SetZero/ARMband/armband.kicad_pcb

## KiCad design armband.kicad_pcb (2024-02-23)

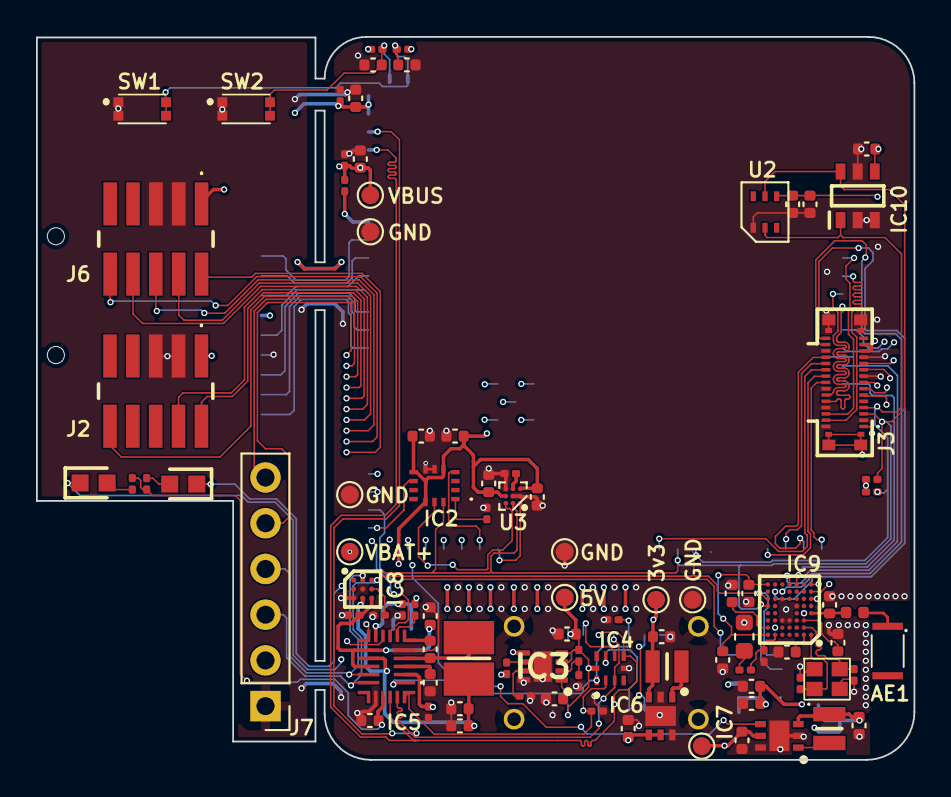
[picture p1: board armband.kicad_pcb from above]

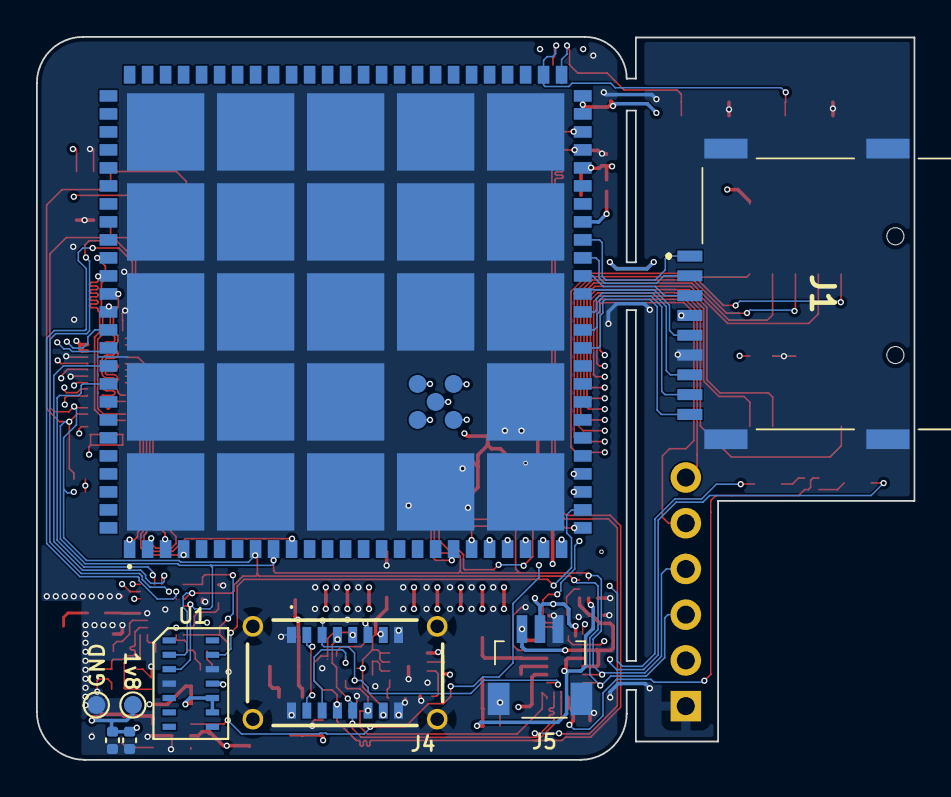
[picture p2: board armband.kicad_pcb from below]

Board: 6 copper layers, 48.8 x 40.2 mm, 101 parts (9 on the bottom side), 90 nets.

Parts:
AE1: Antenna_Chip; ST0147-00-011-A
C1, C2, C4, C6, C7, C8, C9, C25, C26, C29, C30, C31, C33, C40, C41: 100n 16V; C_0402_1005Metric
C3, C5, C11, C22, C32: 1u 6.3V; C_0201_0603Metric
C10: 3n3 50V; C_0402_1005Metric
C12: 22n 25V; C_0402_1005Metric
C13, C14, C15, C16, C17, C19, C20, C21, C27, C28: 10u 6.3V; C_0402_1005Metric
C18, C24, C34: 4u7 6.3V; C_0402_1005Metric
C23, C42: 2u2 6.3V; C_0201_0603Metric
C35, C36: 100p; C_0402_1005Metric
C37, C38: 12p 50V; C_0201_0603Metric
C39: 0p8 16V; C_0402_1005Metric
D1, D2: LED_Small; LEDC1608X80N
IC1: QSMP-1570; QSMP1570_better
IC2: BMI323
IC3: TPS259571DSGR; SON50P200X200X80-9N
IC4: TPD6E001RSERG4
IC5: MP2722GRH-0000-Z; MP2722GRH0000Z
IC6: TPS62291DRVR; SON65P200X200X80-7N
IC7: TPS62293DRVR; SON65P200X200X80-7N
IC8: BQ27427YZFR; BGA9C50P3X3_158X162X62
IC9: nRF52832-CIAA-G-R7; BGA50C40P7X8_296X323X40
IC10: TLE493DW2B6A0HTSA1; SOT95P280X110-6N
J1: MEM2075-00-140-01-A; MEM20750014001A
J2, J6: Conn_02x05_Odd_Even; 2002112100010T4LF
J3: AXF5D3012; display_AXF5D3012
J4: UJ20-C-V-SMT-TR-68; UJ20CVSMTTR68
J5: SM03B-SRSS-TB_LF__SN_; SM03BSRSSTBLFSN
J7: Conn_01x06; PinHeader_1x06_P2.54mm_Vertical
L1: 2u2; INDC3225X120N
L2, L3: 2u2; LQM2MPN1R0NG0L
L4: 10u; L_0603_1608Metric
L5: 15n; L_0201_0603Metric
L6: 3n9; L_0402_1005Metric
R1, R2, R3, R4, R6, R13: 10k; R_0201_0603Metric
R5: 0R; R_0201_0603Metric
R7: 1M; R_0201_0603Metric
R8: 100k; R_0201_0603Metric
R9: 383k; R_0201_0603Metric
R10: 1k; R_0201_0603Metric
R11, R12: 5k1 50mW; R_0201_0603Metric
R14: R_Small; R_0201_0603Metric
R15, R16: 92R; R_0201_0603Metric
SW1, SW2: EVP-BB2A9B000; EVPBB2A9B000
TP1, TP2, TP3, TP4, TP5, TP6, TP7, TP8, TP9, TP10, TP11: TestPoint; TestPoint_Pad_D1.0mm
U1: MAX30102
U2: VEML3235
U3: BMM350; bmm350
Y2: Crystal_GND24; CX2016SA

Connections:
+1V8: C7.1, C8.1, C20.1, C24.1, C25.1, C40.1, C41.1, IC2.5 (VDDIO), IC2.8 (VDD), IC2.12 (CSB), IC7.3 (FB), J3.13 (VIO18), J3.14 (VIO18), L3.1, TP5.1, U1.11 (VDD), U3.B3 (VDDIO), U3.C1 (VDD)
+3V3: C3.1, C4.1, C16.1, C26.1, C27.1, C28.1, C29.1, C30.1, IC1.49 (VIN_1), IC1.50 (VIN_2), IC6.3 (FB), IC10.4 (VDD), J1.P4 (VDD), J2.1, J3.8 (TP_VDD), J3.31 (VPH_PWR), J6.1, J7.2, L2.1, R1.1, R2.1, R3.1, R4.1, R8.1, TP4.1, U1.9 (VLED+), U1.10 (VLED+), U2.4 (VDD)
/supply/VIN_FAULT: IC3.6 (~FLT), R8.2
BMI_INT1: IC1.20 (ENET_CK125), IC2.4 (INT1)
BMI_INT2: IC1.26 (ENET_RXD0), IC2.9 (INT2)
BMM350_INT: IC1.19 (ENET_RST), U3.A1 (INT)
BT_ANT: C39.1, IC9.D1 (ANT), L6.2
DEC2: C35.1, IC9.A2 (DEC2)
DEC3: C36.1, IC9.C2 (DEC3)
DEC4: C32.1, IC9.A6 (DEC4), L5.1
GND: C1.2, C2.2, C3.2, C4.2, C5.2, C6.2, C7.2, C8.2, C9.2, C10.2, C11.2, C13.2, C14.2, C15.2, C16.2, C17.2, C18.2, C19.2, C20.2, C21.2, C22.2, C23.2, C24.2, C25.2, C26.2, C27.2, C28.2, C29.2, C30.2, C31.2, C32.2, C33.2, C34.1, C35.2, C36.2, C37.2, C38.2, C39.2, C40.2, C41.2, C42.2, IC1.101 (EP_1), IC2.6 (GNDIO), IC2.7 (GND), IC3.8 (GND_1), IC3.9 (GND_2), IC4.5 (GND), IC5.5 (PGND), IC5.18 (AGND), IC6.2 (MODE), IC6.6 (GND), IC6.7 (EP), IC7.2 (MODE), IC7.6 (GND), IC7.7 (EP), IC8.B2 (VSS_1), IC8.C1 (VSS_2), IC9.C4 (VSS_1), IC9.C5 (VSS_2), IC9.D2 (VSS_PA), IC9.E3 (VSS_3), IC9.F5 (VSS_4), IC10.2 (GND), IC10.3 (GND_2), IC10.5 (GND_3), J1.MP1, J1.MP2, J1.MP3, J1.MP4 (MP), J1.P6 (VSS), J2.3, J2.5, J3.2 (GND), J3.9 (GND), J3.12 (GND), J3.18 (GND), J3.24 (GND), J3.27 (GND), J3.30 (GND), J4.A1 (GND_1), J4.A12 (GND_2), J4.B1 (GND_3), J4.B12 (GND_4), J4.MH1, J4.MH2, J4.MH3, J4.MH4, J5.3 (GND), J5.MP1 (MP), J5.MP2 (MP), J6.3, J6.5, J7.1, R6.2, R9.2, R10.2, R11.2, R12.2, R14.2, SW1.1 (A), SW2.1 (A), TP7.1, TP8.1, TP9.1, TP10.1, TP11.1, U1.4 (PGND), U1.12 (GND), U2.1 (GND), U3.B1 (GND), U3.B2 (ADSEL), U3.C3 (BYPASS), Y2.2, Y2.4
JTAG_NRST: IC1.A1 (JTAG_TRST_B), J6.10
JTAG_TCK: IC1.C3 (JTAG_TCK), J6.4
JTAG_TDI: IC1.C1 (JTAG_TDI), J6.8
JTAG_TDO: IC1.B2 (JTAG_TDO), J6.6
JTAG_TMS: IC1.A3 (JTAG_TMS), J6.2
LCD_RST: IC1.22 (ENET_MDIO), J3.10 (LCD_RST)
LCD_TE: IC1.21 (ENET_INT), J3.11 (LCD_TE)
MAX_INT: IC1.27 (ENET_RXD1), U1.13 (~INT)
MP2722_INT: IC1.28 (ENET_RXD2), IC5.8 (~INT)
NFC_ANT1: IC9.G6 (NFC1/P0.09), J3.16 (NFC_ANT2)
NFC_ANT2: IC9.G5 (NFC2_/P0.10), J3.17 (NFC_ANT1)
NRF_NRST: IC9.H1 (P0.21_/NRESET), J2.10
NRF_SWCLK: IC9.F1 (SWDCLK), J2.4
NRF_SWDIO: IC9.G1 (SWDIO), J2.2
unnamed: AE1.1 (FEED), L6.1
unnamed: D1.2 (A), R15.1
unnamed: D1.1 (K), IC5.9 (PG/_NTC2)
unnamed: D2.2 (A), R16.1
unnamed: D2.1 (K), IC5.11 (STAT/_IB)
unnamed: IC1.43 (USBA_VBUS), R5.2
unnamed: IC2.1 (SDO), R6.1
unnamed: C10.1, IC3.1 (DVDT)
unnamed: IC3.2 (EN/UVLO), R7.2, R9.1
unnamed: IC3.7 (ILM), R10.1
unnamed: C9.1, IC3.3 (IN_1), IC3.4 (IN_2), IC4.10 (VCC), J4.A4 (VBUS_1), J4.A9 (VBUS_2), J4.B4 (VBUS_3), J4.B9 (VBUS_4), R7.1, TP2.1
unnamed: IC4.1 (IO1), IC5.1 (CC1), J4.A5 (CC1), R11.1
unnamed: IC4.2 (IO2), IC5.22 (CC2), J4.B5 (CC2), R12.1
unnamed: IC4.7 (IO5), J4.A8 (SBU1)
unnamed: IC4.8 (IO6), J4.B8 (SBU2)
unnamed: C12.2, IC5.6 (BST)
unnamed: C21.1, IC5.3 (PMID)
unnamed: C12.1, IC5.4 (SW), L1.1
unnamed: C18.1, IC5.19 (VCC), R15.2, R16.2
unnamed: IC5.7 (VRNTC), R13.1
unnamed: IC6.1 (SW), L2.2
unnamed: IC7.1 (SW), L3.2
unnamed: C23.1, IC8.B3 (VDD)
unnamed: IC9.B6 (DCC), L4.2
unnamed: C31.1, IC9.B7 (DEC1)
unnamed: C33.1, C34.2, IC9.A7 (VDD_1), IC9.H7 (VDD_2)
unnamed: C37.1, IC9.B2 (XC1), Y2.3
unnamed: C38.1, IC9.A1 (XC2), Y2.1
unnamed: J3.5 (NC), J3.15 (NC)
unnamed: L4.1, L5.2
unnamed: C42.1, U3.C2 (CRST)
QSMP_BOOT: C1.1, IC1.52 (BOOT_MODE), R1.2, SW1.2 (B)
QSMP_BUCK_1V8_EN: IC1.29 (ENET_RXD3), IC7.4 (EN)
QSMP_DCX: IC1.10 (INTB), J3.21 (SPI_DCX)
QSMP_DSI_CLKN: IC1.88 (DSI_CKN_LVDS0_CLKN), J3.26 (MIPI_CLKN)
QSMP_DSI_CLKP: IC1.87 (DSI_CKP_LVDS0_CLKP), J3.25 (MIPI_CLKP)
QSMP_DSI_D0N: IC1.86 (DSI_DN0_LVDS0_TX0N), J3.29 (MIPI_DON)
QSMP_DSI_D0P: IC1.85 (DSI_DP0_LVDS0_TX0P), J3.28 (MIPI_DOP)
QSMP_LCD_EN: IC1.25 (ENET_RX_CTL), J3.1 (VCI_EN)
QSMP_MISO: IC1.2 (SPIA_MISO), J3.19 (SPI_SDO)
QSMP_MOSI: IC1.3 (SPIA_MOSI), J3.20 (SPI_SDI)
QSMP_NRST: C2.1, IC1.51 (NRST_PWREN), R2.2, SW2.2 (B)
QSMP_RXD_DEBUG: IC1.89 (UARTA_RXD), J7.5
QSMP_RXD_NRF: IC1.91 (UARTB_RXD), IC9.H4 (P0.15/TRACEDATA[2])
QSMP_SCK: IC1.4 (SPIA_SCK), J3.22 (SPI_CLK)
QSMP_SCL: IC1.8 (I2CB_SCL), IC2.13 (SCX), IC5.16 (SCL), IC8.A3 (SCL), IC9.F7 (P0.06), IC10.1 (SCL_/INT), J3.4 (TP_12C_SCL), J7.3, R3.2, U1.2 (SCL), U2.2 (SDA), U3.A3 (SCK)
QSMP_SDA: IC1.9 (I2CB_SDA), IC2.14 (SDX), IC5.15 (SDA), IC8.A2 (SDA), IC9.E7 (P0.05/_AIN3), IC10.6 (SDA), J3.3 (TP_12C_SDA), J7.4, R4.2, U1.3 (SDA), U2.5 (SCL), U3.A2 (SDA)
QSMP_SS: IC1.1 (SPIA_NSS), J3.23 (SPI_CS)
QSMP_TXD_DEBUG: IC1.90 (UARTA_TXD), J7.6
QSMP_TXD_NRF: IC1.92 (UARTB_TXD), IC9.H3 (P0.16_/TRACEDATA[1])
QSMP_USB_DN: IC1.47 (USBB_DN), IC4.6 (IO4), IC5.20 (D-), J4.A7 (DN1), J4.B7 (DN2)
QSMP_USB_DP: IC1.48 (USBB_DP), IC4.3 (IO3), IC5.21 (D+), J4.A6 (DP1), J4.B6 (DP2)
QSMP_VBUS: C5.1, C6.1, C11.1, IC1.46 (USBB_VBUS), IC3.5 (OUT), IC5.2 (IN), R5.1, TP1.1
SD_CD: IC1.36 (SD_CD), J1.P9 (CD)
SD_CLK: IC1.39 (SD_CLK), J1.P5 (CLK)
SD_CMD: IC1.40 (SD_CMD), J1.P3 (CMD)
SD_D0: IC1.38 (SD_D0), J1.P7 (DAT0)
SD_D1: IC1.37 (SD_D1), J1.P8 (DAT1)
SD_D2: IC1.42 (SD_D2), J1.P1 (DAT2)
SD_D3: IC1.41 (SD_D3), J1.P2 (CD/DAT3)
TH_BAT: IC5.10 (NTC1), J5.2 (TH), R13.2, R14.1
TP_INT: IC1.23 (ENET_MDC), J3.7 (TP_INT)
TP_RST: IC1.24 (ENET_RXC), J3.6 (TP_RST)
VBAT+: C17.1, C22.1, IC5.12 (BATTSNS), IC5.14 (BATT), IC8.C3 (BAT), J5.1 (VCC), TP6.1
VSYS: C13.1, C14.1, C15.1, C19.1, IC5.13 (SYS), IC6.4 (EN), IC6.5 (VIN), IC7.5 (VIN), IC8.C2 (SRX), L1.2, TP3.1
