SetZero/ARMband/(threads)

Thread 1 (2023-02-22):

Check connections on battery, connectors and peripherals

Ihysol, 2023-02-22:
1. check gas gauge connections
    a. pullups are connected to 3v3 from BUCK. So the Battery needs to function first, in order for the PMIC and hence, the pullups to work.
    b. shunt resistor value is TBD

2. check Li-Ion charging connections
    a. led footprint TBD
    b. check R_prog calculation (currently 1k == 1000mA)

3. check connectors
    a. usb connector/pogo pins supply VIN directly (charging input for Li-Ion charger)
    b. connect shield through resistor to GND?
    c. CC and other communication pins from USB-C not needed?

Ihysol, 2023-03-01:
1. a.
- Battery will be charged through connectors
- Once bat voltage is sufficient (should always be or battery dead) the buck will start to work. So it should always work, if a battery is connected and not malfunctioning.
- pullups are only for alert and not general function. So this should not impact functionality of other parts.
- closed

1. b.
- still to do, moving to new issue

2. a.
- led footprint still to be done, moving to new issue

2. b.
- charging current is 1A atm. should be double checked with the battery we're going to use in the future
- closed

3. a.
- schematic changed and issue is obsolete.
3. b.
- should be fine without resistor
3. c.
- schematic changed and this issue is obsolete

Closed 2023-03-01.

Thread 2 (2023-03-01):

Rsens for Li-Ion charger

Ihysol, 2023-03-01:
Li-Ion charger has an inbuilt couloumb counter to subtract power from the digital representation of the battery inside the ic.

Rsens is used to measure the flowing currents and subtract the amount accordingly.

The Rsens value MUST also be set in the IC register REG_CC_CNF by following formula:

CC_CNF = (Rsens * Cnom_bat)/49.556 with Rsens in mOhm and Cnom_bat in mAh.

Default value is 395 after POR.

This means IC config must be done once the system is running, or must be equal to the default value. It is also highly dependant on the used Rsens and Cnom_bat values.

Thread 3 (2023-03-01):

Change to VDD to 1V8

Ihysol, 2023-03-01:
Check all required changes to move from 3V3 to 1V8.

Use BUCK 4, since it can supply the greatest amount of current (2A).

Ihysol, 2023-03-01:
1V8_rework branch added.

TODO: check if all previous connections still run with 1v8.

This was changed for STUSB VSYS, which requires 3V-5V.

Naming convention on STPMIC changed to BUCK#_<voltage> for clearance (BUCK3 and BUCK4 had collisions with the previous naming convention "BUCK_1V8").

Ihysol, 2023-03-01:
List of connections to check for 1V8 compability:

- SD card - ?
- I2C (STUSB, Li-Ion) - OK
- eMMC - ?
- MP1 - ?
