SetZero/ARMband/cubemx/cubemx.ioc

Mcu.UserName=STM32MP157AABx
PA4.Signal=I2S1_WS
PA5.Signal=I2S1_CK
PA6.Signal=I2S1_SDI
PA7.Signal=I2S1_SDO
PB15.Signal=SDMMC2_D1
PB2.Signal=UART4_RX
PB3.Signal=SDMMC2_D2
PB4.Signal=SDMMC2_D3
PB6.Signal=GPIO_Input
PC10.Signal=SDMMC1_D2
PC11.Signal=SDMMC1_D3
PC12.Signal=SDMMC1_CK
PC8.Signal=SDMMC1_D0
PC9.Signal=SDMMC1_D1
PD0.Signal=GPIO_Output
PD1.Signal=GPIO_Input
PD10.Signal=GPIO_Input
PD12.Signal=I2C4_SCL
PD13.Signal=I2C4_SDA
PD2.Signal=SDMMC1_CMD
PD3.Signal=USART2_CTS
PD4.Signal=USART2_RTS
PD5.Signal=USART2_TX
PD6.Signal=USART2_RX
PE0.Signal=GPIO_Input
PE14.Signal=GPIO_Input
PE3.Signal=SDMMC2_CK
PE6.Signal=SDMMC2_D0
PE7.Signal=GPIO_Output
PE8.Signal=GPIO_Output
PF8.Signal=GPIO_Output
PG11.Signal=UART4_TX
PG6.Signal=SDMMC2_CMD
