SetZero/ARMband/(commit log)

2023-02-11 Initial Files
    [gba.kicad_pcb, gba.kicad_sch, power.kicad_sch, ram.kicad_sch]
2023-02-12 Change Symbols / Footprintst to local library
    [gba.kicad_sch, power.kicad_sch, ram.kicad_sch]
2023-02-13 added two mp1 footprint versions
2023-02-13 deleted wrong footprints from library. added symbol and footprint for mp1.
2023-02-16 Modified STM32 Symbol: - moved supply in seperate unit
    [gba.kicad_sch, power.kicad_sch, ram.kicad_sch]
2023-02-19 Connected power rails to mp1
    [gba.kicad_sch, power.kicad_sch]
2023-02-19 added VREV_DDR
    [gba.kicad_sch, power.kicad_sch, ram.kicad_sch]
2023-02-19 Added Symbols
    - MCP73830T
    - STPMIC1BPQR
    - MT41K256M16TW
    - MCP73830
    [power.kicad_sch]
2023-02-19 Added Footprints
    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
2023-02-19 Updated Symbols + Added Supply connections
    [gba.kicad_sch, power.kicad_sch, ram.kicad_sch]
2023-02-19 Added eMMC (S40FC004C1B2C00000)
    [gba.kicad_sch]
2023-02-20 Update eMMC Chip
    [gba.kicad_sch]
2023-02-20 Add comment regarding RAM voltage via software
    [power.kicad_sch]
2023-02-22 Added gas gauge and Li-Ion charging
    [gba.kicad_sch, power.kicad_sch]
2023-02-22 Added Connectors
    [power.kicad_sch]
2023-02-23 Added STUSB1600A chip
    [power.kicad_sch]
2023-02-24 added some part footprints
    [gba.kicad_sch, power.kicad_sch]
2023-02-26 Add Labels for DDR & DDR Power
    [gba.kicad_sch, power.kicad_sch, ram.kicad_sch]
2023-02-27 Add DDR routing to STM32MP1
    [gba.kicad_sch, power.kicad_sch, ram.kicad_sch]
2023-02-27 Add documentation to DDR routing
    [ram.kicad_sch]
2023-02-27 Add Uart to MPU
    [gba.kicad_sch, ram.kicad_sch]
2023-02-28 Add SDcard Adapter
    [gba.kicad_sch, ram.kicad_sch]
2023-03-01 Added Q1 totem-pole circuit for STUSB. Moved components for better visibility.
    [gba.kicad_sch, power.kicad_sch]
2023-03-01 Add level shifter for uSD
    [gba.kicad_sch, power.kicad_sch]
2023-03-01 3v3 to 1V8 rework
    [gba.kicad_sch, power.kicad_sch, ram.kicad_sch]
2023-03-01 cleanup schematic
    [power.kicad_sch]
2023-03-02 Add SDCard connection to mpu
    [gba.kicad_sch, power.kicad_sch]
2023-03-02 Add SDCard Label
    [power.kicad_sch]
2023-03-05 Added nRF Bluetooth Chip
    [communication.kicad_sch, gba.kicad_sch, ram.kicad_sch]
2023-03-07 added footprint for nRF, changed symbol background color, checked connections
    [communication.kicad_sch, gba.kicad_pcb, gba.kicad_sch, power.kicad_sch]
2023-03-08 added supply to nRF
    [communication.kicad_sch, gba.kicad_sch, power.kicad_sch, ram.kicad_sch]
2023-03-08 added decoupling capacitors to mp1
    [communication.kicad_sch, gba.kicad_sch, power.kicad_sch]
2023-03-09 fixed MP1_VDDA_1V8_REG connection
    [power.kicad_sch]
2023-03-19 changed mp1 symbol and moved BYPASS_REG1V8 signal to supply
    [gba.kicad_sch, power.kicad_sch]
2023-03-19 added I2C4 connection to I2C bus and MP1
    [gba.kicad_sch, power.kicad_sch]
2023-03-19 Added I2C interface to pmic and stp
    [gba.kicad_sch, power.kicad_sch]
2023-04-01 added Murata 1YN.kicad_mod
    [power.kicad_sch]
2023-04-01 Added power to murata 1YN
    [communication.kicad_sch]
2023-04-20 Added UART to 1YN
    [communication.kicad_sch, gba.kicad_pcb, gba.kicad_sch, power.kicad_sch, ram.kicad_sch]
2023-04-21 Added STM32MP157AAB_LFBGA354.kicad_mod
    [gba.kicad_sch]
2023-05-19 1YN BT/WLAN connections
    [communication.kicad_sch, gba.kicad_sch]
2023-05-19 Add CubeMX File for STM32MP157
2023-05-19 Add missing Footprints for SDCard
2023-05-19 part cleanup and name change
    [armband.kicad_pcb, armband.kicad_sch, communication.kicad_sch, power.kicad_sch, ram.kicad_sch]
2023-08-14 first power management layout iteration, added footprints and values to parts that had none
    [armband.kicad_pcb, armband.kicad_sch, communication.kicad_sch, power.kicad_sch, ram.kicad_sch]
2023-08-14 added first layout iteration for RAM
    [armband.kicad_pcb]
2023-08-15 Add missing footprints to components
    [armband.kicad_pcb, armband.kicad_sch, communication.kicad_sch, power.kicad_sch, ram.kicad_sch]
2023-08-16 added antenna footprints + solder jumper
    removed gba.kicad_pro
    [communication.kicad_sch]
2023-08-16 added usb connector and usb pin header footprint
    [power.kicad_sch]
2023-08-16 added missing resistors, removed "LibraryLoaderHatesMe" Symbol library
    [armband.kicad_pcb]
2023-08-16 Update local symbols for DDR Pins to global
    [armband.kicad_pcb, power.kicad_sch, ram.kicad_sch]
2023-08-16 reworked RAM
    [armband.kicad_pcb, armband.kicad_sch, ram.kicad_sch]
2023-08-16 reworked RAM layout
    [armband.kicad_pcb]
2023-08-20 Fix RAM Labels
    [armband.kicad_sch, ram.kicad_sch]
2023-08-21 added flash
    [armband.kicad_sch, flash.kicad_sch]
2023-08-21 removed unneccessary parts + first ram layout iteration
    [armband.kicad_pcb, armband.kicad_sch, communication.kicad_sch, power.kicad_sch, ram.kicad_sch]
2023-08-21 ddr3 routing progress
    [armband.kicad_pcb]
2023-08-22 progressed ram layout (connected communication pins)
    [armband.kicad_pcb]
2023-08-23 added dummy resistors for ddr3 layout connections and progressed layout
    [armband.kicad_pcb]
2023-09-23 clock lines
    [armband.kicad_pcb]
2023-09-23 clock meander madness
    [armband.kicad_pcb]
2023-09-23 Add Net Classes + CLK length matching
    [armband.kicad_pcb]
2023-09-23 Add vias and routes for addr lines
    [armband.kicad_pcb, armband.kicad_sch]
2023-09-23 connected address pins of ddr3
    [armband.kicad_pcb, armband.kicad_sch]
2023-09-26 first length matching iteration
    [armband.kicad_pcb]
2023-09-26 Change DDR clk length from 40 to 37mm
    [armband.kicad_pcb]
2023-09-28 Add wiring for Data lines + remove ground layer in favor for signal layer
    [armband.kicad_pcb]
2023-09-30 cleaned traces, reworked and lengthmatched datalines
    [armband.kicad_pcb]
2023-09-30 Check and fix length matching
    [armband.kicad_pcb]
2023-10-01 Fix some DRC warnings
    [armband.kicad_pcb, ram.kicad_sch]
2023-10-01 loeschanfall + new start
    [armband.kicad_pcb]
2023-10-02 reworked currently set traces, constrained length of address traces between 18 and 26mm
    [armband.kicad_pcb]
2023-10-02 Add termination resistor conenctions + via for DQ
    [armband.kicad_pcb]
2023-10-14 routed datalines - gl lengthmatching that!
    [armband.kicad_pcb]
2023-11-24 preperation for lengthmatching (probably 24.5mm +- 0.635)
    [armband.kicad_pcb]
2023-11-25 progressed length matching
    [armband.kicad_pcb]
2023-11-25 lengthmatched ddr traces to 24.5mm +-0.625mm
    [armband.kicad_pcb]
2023-12-11 lengthmatching finalized
    clk_p, clk_n also matched to 24.5mm
    [armband.kicad_pcb]
2023-12-18 added QSMP1570 symbol and footprint to project. Modified Symbol. Cleaning of schematic.
    [armband.kicad_sch, flash.kicad_sch, peripherals.kicad_sch, power.kicad_sch, ram.kicad_sch, supply.kicad_sch, untitled.kicad_sch]
2023-12-19 added boot buttons and voltage rail labels
    [armband.kicad_pcb, armband.kicad_sch, flash.kicad_sch, power.kicad_sch, ram.kicad_sch, untitled.kicad_sch]
2023-12-19 added selection of charging ICs as text
    [armband.kicad_sch]
2023-12-20 added mezzanine connector for display
    [armband.kicad_sch]
2023-12-25 added debug breakout components (SD, Header for I2C + JTAG)
    [armband.kicad_sch, debug.kicad_sch]
2023-12-27 added symbols and footprints for peripherals
    [armband.kicad_sch]
2023-12-27 added hierachical sheets
    [6dof.kicad_sch, BLE + NFC.kicad_sch, armband.kicad_sch, biometric sensor.kicad_sch, display.kicad_sch, supply.kicad_sch, untitled.kicad_sch]
2023-12-27 Update Pull-Ups for I2C/Boot/NRST
    [armband.kicad_sch]
2023-12-27 progressed charging and gas gauge schematic
    [6dof.kicad_sch, BLE + NFC.kicad_sch, armband.kicad_sch, biometric sensor.kicad_sch, debug.kicad_sch, display.kicad_sch, supply.kicad_sch]
2023-12-28 added buck
    [6dof.kicad_sch, BLE + NFC.kicad_sch, armband.kicad_sch, biometric sensor.kicad_sch, display.kicad_sch, supply.kicad_sch]
2023-12-29 added new bucks
    [supply.kicad_sch]
2023-12-29 buck circuits
    [supply.kicad_sch]
2023-12-29 Add Inductor LQM2MPN2R2MG0L
    [supply.kicad_sch]
2023-12-30 added usb connector
    [armband.kicad_sch, connectors.kicad_sch, supply.kicad_sch]
2023-12-31 added usb protection
    [armband.kicad_sch, connectors.kicad_sch]
2024-01-01 Update capacitor values
    [connectors.kicad_sch]
2024-01-01 finished usb connection ciruits
    [armband.kicad_sch, debug.kicad_sch, supply.kicad_sch, usb.kicad_sch]
2024-01-01 switched to other charge + protection IC
    [armband.kicad_sch, supply.kicad_sch, usb.kicad_sch]
2024-01-01 Update resistors + LED values
    [supply.kicad_sch]
2024-01-02 Add MNR for LED
    [supply.kicad_sch]
2024-01-02 fixed display connector
    [display.kicad_sch, supply.kicad_sch]
2024-01-02 added TVS diodes and cleaned up supply.kicad_sch
    [supply.kicad_sch]
2024-01-02 Add i2c device list
    [armband.kicad_sch]
2024-01-04 added decoupling capacitors to sensors
    [6dof.kicad_sch, armband.kicad_sch, biometric sensor.kicad_sch, display.kicad_sch, supply.kicad_sch]
2024-01-04 added signal connections to QSMP
    [armband.kicad_sch]
2024-01-05 cleaned up supply labels
    [armband.kicad_sch, biometric sensor.kicad_sch, display.kicad_sch]
2024-01-05 added buttons (with symbol that is not trash)
    [armband.kicad_pcb, armband.kicad_sch]
2024-01-05 added SBU pins to TVS diodes, changed button pullup resistors (QSMP)
    [armband.kicad_sch, supply.kicad_sch]
2024-01-05 added ambient light_sensor.kicad_sch
    [armband.kicad_pcb, armband.kicad_sch, biometric sensor.kicad_sch, light_sensor.kicad_sch, supply.kicad_sch]
2024-01-08 cleaned up symbol fields table and removed unused or duplicate fields.
    [6dof.kicad_sch, BLE + NFC.kicad_sch, armband.kicad_sch, biometric sensor.kicad_sch, debug.kicad_sch, display.kicad_sch, light_sensor.kicad_sch, supply.kicad_sch]
2024-01-08 switched to I2CB (so both M4 and A7 access), added 1v8 enable gpio and removed connection to vin
    [armband.kicad_sch, supply.kicad_sch]
2024-01-13 added rotary_encoder.kicad_sch and magnetic sensor for it
    [armband.kicad_sch, rotary_encoder.kicad_sch]
2024-01-13 added magnetc sensor address to i2c address table
    [armband.kicad_sch]
2024-01-13 Add battery connector footprint
2024-01-13 Update battery connector in schematic
    [supply.kicad_sch]
2024-01-13 Add nRF base layout
    [BLE + NFC.kicad_sch]
2024-01-13 added XTAL to nrf chip
    [BLE + NFC.kicad_sch, armband.kicad_sch, display.kicad_sch, supply.kicad_sch]
2024-01-13 updated BLE + NFC.kicad_sch
    - added antenna footprint
    - added impedance matching
    - added inductors on DCC pin
    - changed various symbol values to match conventions (e.g. 0.9uH -> 0u9)
    [BLE + NFC.kicad_sch]
2024-01-13 updated BLE + NFC.kicad_sch
    - added pins for I2C slave communication
    - added connections to I2C pins and SWD/JTAG interface
    [BLE + NFC.kicad_sch, armband.kicad_pcb, armband.kicad_sch]
2024-01-14 Update JTAG
    Add Footprint for JTAG connector
    Add NRF connections
    [BLE + NFC.kicad_sch, armband.kicad_sch, debug.kicad_sch]
2024-01-14 updated schematic
    - renamed JTAG (QSMP) and SWD (NRF) labels
    - added footprint to misc. connector in debug.kicad_sch
    [armband.kicad_sch, debug.kicad_sch]
2024-01-17 added bmm350.kicad_mod and changed 9dof.kicad_sch
    + added symbol and footprint for magnetometer BMM350
    + changed supply of BMI (6dof) to 1v8
    [9dof.kicad_sch, armband.kicad_sch]
2024-01-17 Update 3d models
    [armband.kicad_pcb, armband.kicad_sch]
2024-01-21 changed display footprint
    - added new display_AXF5D3012.kicad_mod (from old AXF5D3012.kicad_mod)
    - updated display symbol to use new footprint
    [display.kicad_sch]
2024-01-21 updated display_AXF5D3012.kicad_mod footprint
    - added outlines
    [armband.kicad_pcb]
2024-01-21 first layout iteration
    [armband.kicad_pcb, display.kicad_sch, supply.kicad_sch]
2024-02-10 progressed layout, adjusted some courtyard sized to be smaller
    [armband.kicad_pcb, supply.kicad_sch]
2024-02-11 progressed layout
    [BLE + NFC.kicad_sch, armband.kicad_pcb, armband.kicad_sch]
2024-02-11 there was an attempt to length match DSI
    [armband.kicad_pcb]
2024-02-11 Update length matching
    [armband.kicad_pcb]
2024-02-12 Add Heartbeat sensor to PCB
    [armband.kicad_pcb]
2024-02-15 Add debug location
    [armband.kicad_pcb]
2024-02-16 progressed layout and made changes in bmi323 (set unconnected pins to NC) + changed debug connections in preparation to make bridges to debug part + changed VSYS, VUSB, VBAT+ and other connected powe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
    [9dof.kicad_sch, armband.kicad_pcb, armband.kicad_sch]
2024-02-16 added edge.cuts
    [armband.kicad_pcb]
2024-02-16 Reduce DRC findings
    [armband.kicad_pcb]
2024-02-16 Add debug connections
    [armband.kicad_pcb]
2024-02-16 Improve some connections
    [armband.kicad_pcb]
2024-02-17 fixed drc errors
    [armband.kicad_pcb]
2024-02-17 Update USB length matching
    [armband-B_Mask.gbs, armband-B_Paste.gbp, armband-B_SIGNAL_Cu.gbl, armband-B_Silkscreen.gbo, armband-Edge_Cuts.gm1, armband-F_Mask.gts, armband-F_Paste.gtp, armband-F_SIGNAL_Cu.gtl]
2024-02-18 added QSMP1570_better.kicad_mod and part designators, moved production files into own folder
    [armband-B_Mask.gbs, armband-B_Paste.gbp, armband-B_SIGNAL_Cu.gbl, armband-B_Silkscreen.gbo, armband-Edge_Cuts.gm1, armband-F_Mask.gts, armband-F_Paste.gtp, armband-F_SIGNAL_Cu.gtl]
2024-02-18 Fix unconnected nets
    [armband.kicad_pcb, biometric sensor.kicad_sch]
2024-02-18 Add gnd connection for OLED connector
    [armband.kicad_pcb]
2024-02-18 rounded corners
    [armband.kicad_pcb]
2024-02-19 fixed unneccessary traces
    [armband.kicad_pcb]
2024-02-22 added test points
    [armband.kicad_pcb, supply.kicad_sch]
2024-02-22 Added LED
    [armband.kicad_pcb, supply.kicad_sch]
2024-02-23 fixed silkscreen errors
    [armband.kicad_pcb]
2024-02-26 added jlcpcb conform production files
    [armband-B_Mask.gbs, armband-B_Paste.gbp, armband-B_SIGNAL_Cu.gbl, armband-B_Silkscreen.gbo, armband-Edge_Cuts.gm1, armband-F_Mask.gts, armband-F_Paste.gtp, armband-F_SIGNAL_Cu.gtl]
2024-03-01 added missing MFN numbers
    [9dof.kicad_sch, BLE + NFC.kicad_sch, armband.kicad_sch, biometric sensor.kicad_sch, debug.kicad_sch, display.kicad_sch, light_sensor.kicad_sch, rotary_encoder.kicad_sch]
2024-03-09 Update to KiCad 8 + Add/Fix voltage selector for nRF
    [9dof.kicad_sch, BLE + NFC.kicad_sch, armband.kicad_sch, biometric sensor.kicad_sch, debug.kicad_sch, display.kicad_sch, light_sensor.kicad_sch, rotary_encoder.kicad_sch]
